Luisa-02/Sistema-de-Amplificaci-n/README.md

# Sistema-de-Amplificacion
Proyecto de diseño e implementación de un amplificador BJT de tres etapas (EC, EC, CC)
Grupo 2: Luisa Peñaranda, Stiven Martínez, Maria Angel Lopez, Luis Mercado, Haslhy Palencia
### Simulación del proyecto (MULTISIM)
### Script cáculos (Calculador-amplificador)
### Informe Proyecto
### Diseño de pcb
### Presentación Amplificador Multietapas
### excel con los gastos
