Luisa-02/Sistema-de-Amplificaci-n/Informe Proyecto final.pdf

# Amplificador Multietapa BJT

PROYECTO 1 – ELECTRÓNICA II

María Ángel López Pianeta, Stiven Jesús Martinez Ariza, Luis Alberto Mercado Henao, Haslhy Palencia Bolívar, Luisa Fernanda Peñaranda Noguer.

resumen—En el presente informe se presenta el procedimiento seguido para la elaboración de un circuito amplificador conformado por tres etapas junto al análisis experimental de cada una de ellas y las respectivas mediciones obtenidas durante el proceso de montaje. El Objetivo del Proyecto fue obtener una ganancia de voltaje entre 300 a 400, además de trascender la teoría a la práctica y testear los conocimientos adquiridos.

Abstract— In this report, the procedure followed for the construction of a three-stage amplifier circuit is presented, along with the experimental analysis of each stage and the corresponding measurements obtained during the assembly process. The objective of the project was to achieve a voltage gain between 300 and 400, as well as to translate theoretical knowledge into practice and test the concepts learned.

I. INTRODUCCIÓN
Generalmente las señales generadas por fuentes como teléfonos, micrófonos o reproductores resultan con niveles de voltaje o corriente relativamente bajos. Debido a esto el uso de circuitos amplificadores de audio se vuelve indispensable para incrementar estas señales eléctricas de entrada y obtener ganancias aceptables, permitiendo tener una reproducción audible y eficiente.

Es fundamental entender que la ganancia representa una relación adimensional entre la magnitud de la señal de salida y la magnitud de la señal de entrada e indica cuánto se amplifica la misma. Para los fines de este proyecto utilizamos dos tipos:

- Ganancia de voltaje:

Vout
Av = −
Vin
- Ganancia de corriente:

Iout
Ai =
Ie
n

IEEE
Para el diseño de estos amplificadores el uso de semiconductores como el transistor bipolar BJT es ampliamente utilizada debido a su capacidad de manipular grandes cantidades de corriente entre dos de sus terminales (Colector y emisor) a través de señales pequeñas de entrada (Base). Estos dispositivos sen configuran adecuadamente con ayuda de redes de polarización, resistencias y capacitores de acoplamiento, logrando puntos de operación estables y amplificaciones lineales.

En este proyecto se coloca en práctica la teoría aprendida y se aprovecha al máximo la eficiencia de los transistores bipolares a la hora de controlar señales, facilitando el diseño y la implementación de tres etapas de amplificación para obtener una ganancia aceptable dentro del rango requerido.

II.OBJETIVOS

Diseñar, analizar, simular e implementar un amplificador multietapa basado en transistores BJT, con el propósito de obtener una ganancia de voltaje en el rango de 300 a 400 mediante el acoplamiento de diferentes etapas de amplificación y verificar su funcionamiento a través de simulación y montaje práctico.

III. DESARROLLO

Para el diseño del circuito amplificador se tomaron varias consideraciones: Se estableció que Vcc = 16V y que la ganancia objetivo estaría en un rango de 350-390.

Para facilitar el cálculo de los valores de los componentes del circuito se consideró realizar el análisis en DC desde la última hasta la primera etapa del amplificador.

Etapa 3

Colector común.

Esta topología fue elegida tercera etapa ya que permite que el sistema pueda alimentar la carga de manera eficiente sin reducir la amplitud de la señal.

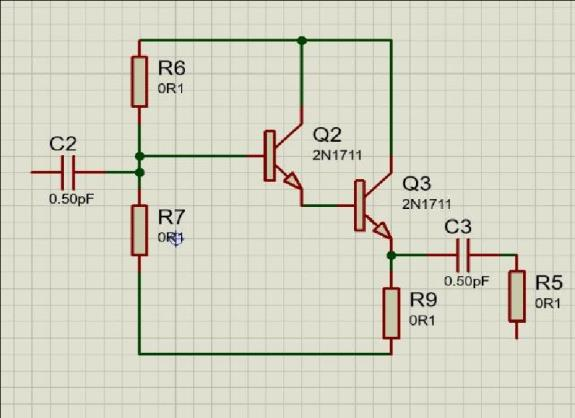
[picture p2: figure]

1. Cálculo de componentes y análisis en AC.

Para el parlante se utilizó uno de 8Ω con una potencia de 60W. Se conectó en paralelo a la resistencia del emisor a través de un capacitor. Para la resistencia del emisor se utilizó la siguiente condición de diseño:
Re RL

Se buscó el valor comercial más cercano a 8Ω en resistencias, por lo que para Re finalmente se utilizó una de 10Ω.

También se tomó en cuenta que:

Vce =

VCC
2

Vce =

20
2

= 10

Luego se realiza una malla en colector-emisor para hallar la corriente que pasa por el emisor:

−Vcc + Vce + Vre = 0

−16V + 10V + ReIe = 0

Ie =

20v − 10v
10Ω
Ie = 1A

Hacemos que:
Ic Ie → Ic = 1A

Una vez obtenida la corriente del colector es posible hallar la corriente de base.

Ib =

1A
51000
Ib = 1.9 μA

Para esta etapa se emplea un par Darlington. Se conectó el emisor de un transistor a la base del otro, además de conectar ambos colectores. Con esta configuración es posible decir que la multiplicación de las ganancias individuales de estos componentes representa el factor de ganancia total de la etapa.

Esto significa que se ambos valores de beta se multiplican y que el voltaje base emisor total es la suma de los individuales.

β βt

Por ende:

Ib =1.9µA

El transistor posee una resistencia dinámica en el terminal del emisor, la cual se calcula así:
26mV
re = | Ie
26mV
re =
800mA
re = 0.0325Ω

Para el diseño de esta etapa se asignó el valor de la resistencia de base como:
RB = 24 KΩ

Con estos valores ya es posible calcular el valor de VBB. Para esto realizamos la siguiente malla:
−VBB + RBIb + Vbe + Vce = 0

Reemplazando valores tenemos que:
VBB = 9.77V

Una vez obtenido este valor ya se puede hallar el valor de las resistencias para el divisor de voltaje:
Vcc RB
R
VBB
Reemplazando valores:
R1 = 49KΩ

Ahora:

R2 =

RB

1 −

VBB
VCC
R2 = 47KΩ

Finalmente se calcula la resistencia de entrada del circuito:

Ren = RB || (reβ+Reβ)

Reemplazando valores:
Ren = 16KΩ

Resulta ventajoso utilizar un par Darlington en la etapa de colector común ya que ofrece una alta ganancia de corriente, ya que se representa por el producto de la ganancia de ambos transistores, además de poseer una resistencia de entrada elevada, idear para acoplar etapas de alta impedancia.

Etapa 2

Emisor común

Con el fin de invertir la señal que proviene de la primera etapa (desfasada 180°) y de obtener una ganancia más alta, se utiliza nuevamente la topología de emisor común.

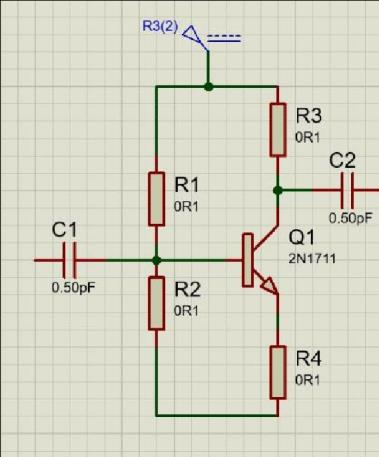
[picture p3: figure]

Se tomaron algunas consideraciones de diseño:

RC = 0.1*RL

Ve=[10%-15%]Vcc

Luego se calcula el valor de RL

RL = RB||(re + RE||RL)β

Estos valores corresponden a los de la tercera etapa. Reemplazando tenemos:

RL

RL = 21,7KΩ
RC = 2170
- Para esta etapa se estableció una ganancia de 20 con el fin de llegar a la ganancia total objetivo.

Ganancia en un emisor común:

Av = | Rc||R L)
| re+RE1

Como re es muy pequeña se desprecia:

Av = (RC||RL)/RE1

Despeje de Re1:
20 = (2170Ω||21.7kΩ)/RE1

RE
RE1 = 98.6Ω

Re ≈ 100Ω

Para el voltaje de emisor se utilizó la siguiente condición de diseño:
Ve = [10% − 15%]Vcc
Ve = 0.125Vcc

Ve= 2V

Malla colector-emisor:

VCC= VRC+ VCE + VE

VRC= 20 − 10 − 2

VRC = 8V Corriente

del colector:

VRC
IC=
Rc

IC=
IC= 2.76mA

Se sabe que:

IC≈ IE

Resistencia interna del emisor: 26mV
re=
IE
26mV
re=
2.76mA
re= 9.4Ω

La resistencia del emisor se calculó de la siguiente forma:

VE
RE
I

RE=
2.76mA
RE= 724Ω

Posteriormente se calculó RE2:

RE= RE1 + RE2

724Ω = 100Ω + RE2

RE2 = 624Ω ≈ 600Ω

=
E
2

Se calcula la resistencia de la base, para ello se utiliza la condición de diseño: RB= 0.1βRE

RB = 0.1 ∗ 350 ∗ 700Ω

RB = 24kΩ

Luego se halla el valor de la corriente que pasa por la b ase:

IC
IB = β
2.76mA
IB =
| 350
IB = 7.88µA

Parra encontrar VBB se realiza una malla en base- emisor:

−VBB+ IBRB+ VBE + VE = 0

VBB = 24kΩ ∗ 7.88µA + 0.7V + 2V VBB

= 2.88V

Finalmente, y con todos estos valores, es posible calcular el valor de las resistencias R1 y R2.

Divisor de voltaje:

R

| VBB

R1 =

20 ∗ 24000
| 2.88
R1 ≈ 130kΩ

Para R2:
R2 = | RB
1 − | VBB VCC
R2 = | 24K
1 − | 2.88V
| 20

R2 ≈ 30kΩ

Etapa 1

Esta configuración permite amplificar tanto la tensión de entrada como la corriente de entrada. Esto es útil en etapas amplificadoras de entrada e intermedias, donde es necesario elevar tanto la tensión como la corriente de la señal de entrada.

Emisor común

Se calcula la resistencia de carga:

RL= RB2||(βre+ βRE)

RL= 24k||(350 ∗ 9.4 + 350 ∗ 700)

RL≈ 22kΩ

Para hallar el valor de la corriente que pasa por el colector se realiza una malla que permita hallar el valor del voltaje que pasa por esa resistencia.

Malla colector-emisor:

VCC= VRC+ VCE + VE

VRC= 20V − 10V − 2V
VRC= 8V

Nota: Para el voltaje del emisor se utilizó la misma condición de diseño que la siguiente etapa: Ve=[10%-15%]Vcc

Luego, para calcular el valor de la resistencia se aplica la siguiente condición de diseño:
Rc = 0.1 ∗ RL

Rc = 2.2kΩ

Una vez se obtienen estos valores ya es posible hallar Ic:

Vrc
Ic =
Rc
6V
IC=
2200Ω
IC= 2.72mA

Se sabe que: Ic ≈ Ie → Ie = 2.72mA

Posteriormente se calcula la resistencia interna del emisor:

re= 26mV/IE
26mV
re=
2.72mA
re= 9.5Ω

Ahora, se calcula la resistencia del emisor utilizando la ley de Ohm:

RE =

VE
IE

RE =

2V
2.72mA
RE= 735Ω
- Para esta etapa se definió una ganancia de 20 con tal de llegar al rango de ganancia deseada.

Para hallar RE1 y RE2 es necesario utilizar la fórmula de ganancia para un emisor común, despreciando el valor de re y despejando el valor deseado.
(2200Ω||22kΩ)
20 =

RE1

RE1 =
RE1 = 100Ω Se

calcula RE2:

RE= RE1 + RE2

735Ω = 100Ω + RE2

RE2 = 635Ω

Corriente de base:

IC
IB =
β
2.72mA
IB =
360
IB = 7.56µA

Para calcular el valor de la resistencia de la base se utiliza la siguiente condición de diseño:

RB = 0.1 ∗ 360 ∗ 600Ω

RB = 21600Ω

Corriente de base:

IC
IB =
β
2.72mA
IB =
360
IB = 7.56µA

Luego se realiza una malla para calcular el valor de VBB: −VBB + 21600Ω ∗ 7.56µA + 0.7V + 2V = 0

VBB = 2.86V

Por último se calcula el valor de R1 y R2:

R1

VCC ∗ RB
R1 =

VBB

R1 =

20 ∗ 21600
2.86

R1 = 120KΩ

R2

R2 =

21600

1 −

2.86
20

R2 = 26KΩ

Para hallar el valor de los capacitores de acople y Bypass de cada una de las etapas utilizamos la siguiente expresión:

1
Xc =
2πfC
En circuitos amplificadores los capacitores de acople se utilizan para bloquear corrientes en DC y dejar pasar la señal AC. Para que esta pase limpiamente y sin atenuaciones la reactancia capacitiva debe ser mucho menor que la impedancia de entrada.

1
Zin >
2πfC

En este orden, los valores de los capacitores del amplificador, por etapas, son los siguientes:

Etapa 1

- C1: 10µF → Entrada
- C2:100 µF→ Bypass
- C3:100 µF→ Conecta la etapa 1 con la etapa 2.

Etapa 2

- C4: 100 µF→ Bypass
- C5: 100 µF→ Conecta etapa 2 con la etapa 3

Etapa 3

- C6: 2200 µF→ Conecta a RL con el emisor.

Nota importante: Los cálculo teóricos fueron realizados considerando una fuente de alimentación de 16 V. Durante la simulación del sistema multietapa se utilizó una fuente de 20 V, lo cual modifica ligeramente el punto de operación del transistor, principalmente el voltaje colector-emisor. Sin embargo, la ganancia del amplificador depende principalmente de las resistencias del circuito y de la resistencia dinámica del transistor, por lo que el comportamiento general del amplificador no se ve significativamente afectado.

2. Polarización del transistor y punto de operación.

La polarización del transistor consiste en fijar un punto de operación estable de tal manera que los transistores puedan operar en región activa. Para lograrlo se implementa un divisor de voltaje en la base y una resistencia en el emisor con el fin de estabilizar la corriente del colector y obtener una amplificación lineal.

> | Los transistores utilizados fueron:
| • Primera etapa: BC547B • Segunda etapa: BC547B • Tercera etapa: BC547B y TIC41C.
3. Simulación

Una vez obtenidos los valores de los componentes mediante los cálculos correspondientes, se procedió a simular el circuito en el programa MULTISIM.

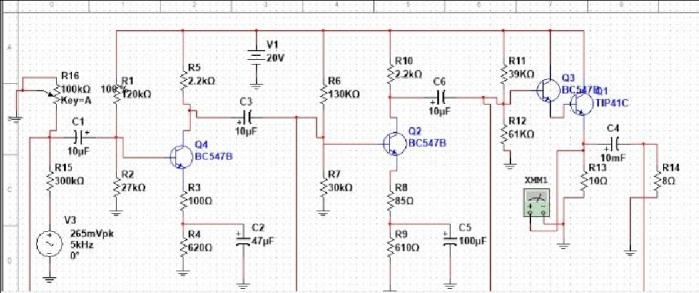
[picture p4: figure]

4. Posteriormente se realizó el diseño de la PCB en el programa Proteus.

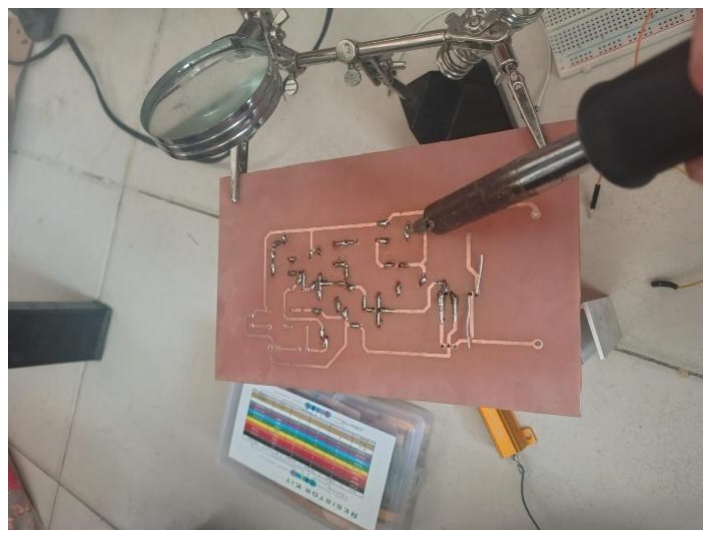
[picture p5: figure]

5. PCB en 3D

Adicionalmente también se realizó una simulación de la PCB en 3D, igualmente en el programa Proteus.

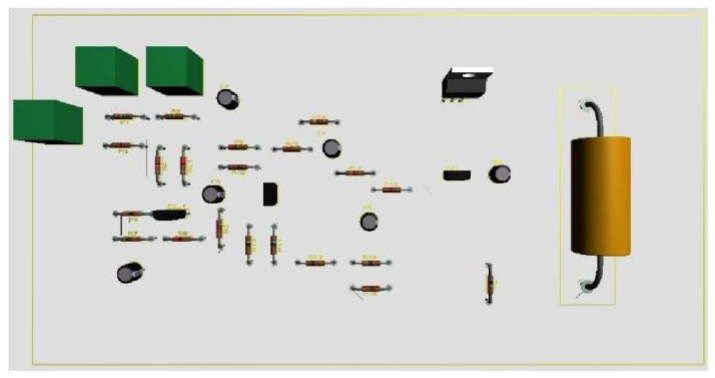
[picture p6: figure]

6. Montaje del circuito.

Posteriormente a elaborar todas las guías de diseño se procedió a preparar la placa de cobre para montar el circuito. Para esto se imprimió el layout de la PCB para luego aplicar calor con una plancha de tal manera que se pueda transferir el tóner. Se aplica el ácido a la placa para remover todo el cobre sobrante.

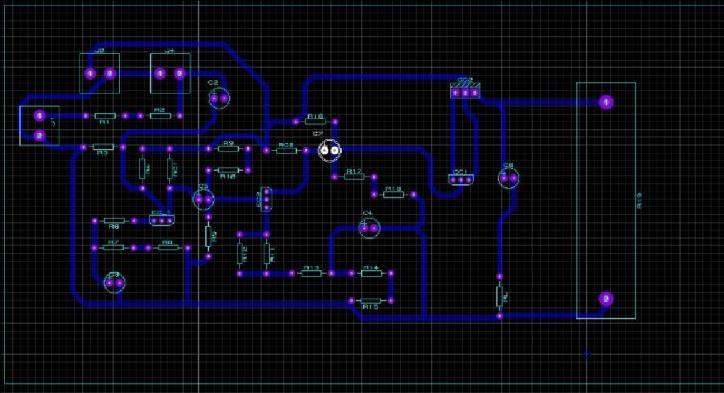
[picture p7: figure]

Luego de realizar los agujeros en la PCB se procede a montar el circuito para realizar el ensamble correspondiente.

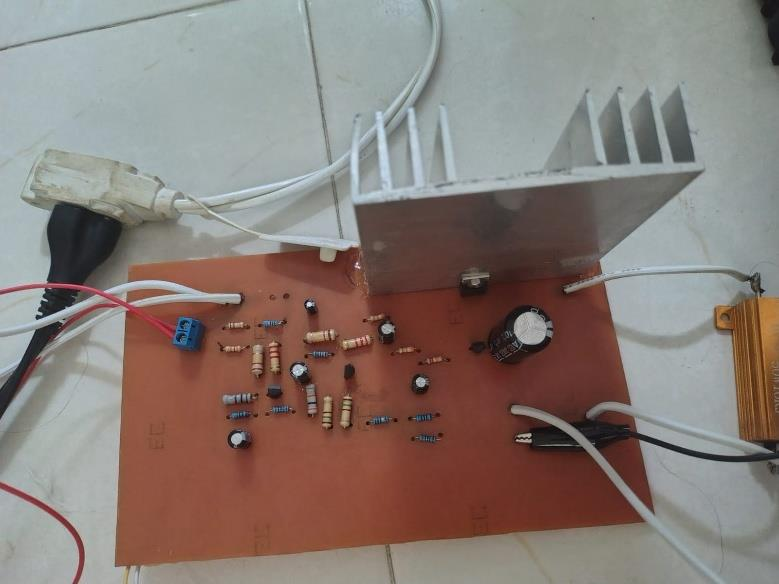
[picture p8: figure]

IV. RESULTADOS Y MEDICIONES

Una vez finalizado el montaje del circuito amplificador multietapa y verificado el correcto funcionamiento de cada una de las etapas, se procedió a realizar las mediciones experimentales del sistema completo. Para la prueba se utilizó una señal de entrada AC de aproximadamente 7 mV, aplicada en la entrada del amplificador.

Debido a que la amplitud de la señal de entrada es muy pequeña, se presentaron ciertas limitaciones al momento de utilizar el osciloscopio, ya que este instrumento no logró captar con suficiente precisión señales de tan baja magnitud, generando lecturas inestables y con errores apreciables. Por esta razón,para obtener un valor más confiable de la señal se decidió realizar la medición utilizando un multímetro digital, el cual permitió obtener una lectura más estable del voltaje presente en la salida del amplificador.

A partir de las mediciones realizadas se obtuvo una ganancia total del amplificador de aproximadamente 362.245, valor que se encuentra dentro del rango de diseño establecido para el proyecto, el cual era de 300 a 400. Este resultado confirma que el diseño de las tres etapas de amplificación, así como el acoplamiento entre ellas, fue adecuado para lograr la amplificación deseada de la señal de entrada.

Los resultados obtenidos experimentalmente presentan una buena concordancia con los valores teóricos y de simulación previamente calculados durante la etapa de diseño. Las pequeñas diferencias observadas pueden atribuirse a factores como las tolerancias de los componentes electrónicos, variaciones en el parámetro β de los transistores y las limitaciones propias de los instrumentos de medición utilizados durante el laboratorio.

En general, las mediciones realizadas permiten concluir que el amplificador multietapa construido cumple satisfactoriamente con los objetivos planteados, logrando amplificar una señal de entrada muy pequeña hasta obtener una señal de salida considerablemente mayor y apta para ser utilizada en aplicaciones de audio.

V. CONCLUSIÓN

En este proyecto se analizó y construyó un amplificador multietapa con el fin de estudiar el comportamiento de los transistores BJT en diferentes configuraciones además de su interacción en un mismo sistema. Se realizaron los cálculos necesarios para encontrar los valores de los componentes y establecer un punto de operación Q estable con el objetivo de lograr una amplificación de la señal.

La primera etapa, implementada en configuración de emisor común, permitió obtener una ganancia aceptable de voltaje a partir de una pequeña señal de entrada. Junto con las otras etapas, se pudo obtener una alta ganancia total del circuito y, una vez acopladas, ayudaron a proporcionar la capacidad necesaria para entregar una alta señal a la carga.

Durante el proceso de diseño y análisis se evidenció la importancia de parámetros como la ganancia, la polarización mediante divisor de voltaje y la correcta selección de los componentes, así como también el entender conceptos como los parámetros que limitan la capacidad de los equipos de medición, ya que estos presentan ciertas limitaciones que complican la obtención de resultados.

El desarrollo de este proyecto permitió consolidar los conceptos teóricos aprendidos acerca de los transistores y su polarización a través de la práctica, además de comprender la importancia de un adecuado análisis de polarización y acoplamiento entre etapas.
