Luisa-02/Sistema-de-Amplificaci-n/Costos proyecto1.xlsx

TABLA DE COSTOS PROY 1: AMPLIFICADOR POR FASES
N° | MATERIALES | COSTOS | SUMATORIA
2 | Resistencia 10ohm a 10w | 2000 | 2000
2 | Capacitor10x5v | 600 | 2600
24 | Resistencia de 1/2W | 2400 | 5000
1 | Capacitor 1000X506 | 1500 | 6500
2 | Capacitor 100X25 | 600 | 7100
2 | 2.2 *50 | 600 | 7700
1 | cabeza estereo 1X1 1.5 min | 5000 | 12700
1 | bolsa | 100 | 12800
1 | Dicipador | 10000 | 22800
1 | PCB | 22500 | 45300
1 | Resistencia de 50w | 7500 | 52800
1 | Carcasa del parlante | 30000 | 82800
2 | Puerto Jack y Resistencias | 5500 | 88300
2 | Flux y estaño | 5000 | 93300
1 | Parlante | 16000 | 109300
2 | Cableado | 4200 | 113500
 | TOTAL GASTOS |  | 113500
