Luisa-02/Sistema-de-Amplificaci-n/(list of files, drawings)

Other design files:
simulacion proyecto.ms14
